Shubhjaiswal408/kbc-fastest-finger-first/(commit log)

2026-11-03 KBC Buzzer: Fastest Finger First quiz system for ESP32
    - Host firmware: game logic, ESP-NOW radio, non-blocking web server,
    embedded web app (gzip), optional school Wi-Fi via wifi_secrets.h
    - USB buzzer firmware (ESP32): self-pairing, fair reaction timing,
    live button test, logs over the radio
    - Battery buzzer firmware (XIAO ESP32-C6, beta): deep sleep between
    presses, self-calibrated wake delay
    - Web app: teacher console, KBC-style big screen, 2-4 option questions,
    scoreboard, history, button test, logs, settings; demo mode
    - Docs: README, user guide, hardware guide, screenshots, wiring diagrams
    [KBC_BatteryC6.ino, KBC_Host.ino, KBC_Node.ino, mini_web.h, protocol.h, wifi_secrets.example.h]
2026-11-04 Add ESP32-C3 SuperMini battery buzzer firmware (beta) and docs
    [KBC_BatteryC3.ino, protocol.h]
2026-11-04 C3 battery buzzer: fix Wi-Fi (lower TX power), add wiring check and diagnostics; show battery buzzers as asleep
    - C3 SuperMini: TX power 8.5 dBm (fixes boards with a poorly tuned antenna)
    - 15 s wiring check after power-on, reset reason and pin levels in the boot log
    - Report wake-ups with no pin flagged instead of sleeping silently
    - Web app: battery buzzers show an amber 'asleep' state and a separate count
    [KBC_BatteryC3.ino]
2026-11-05 Make the ESP32-C3 SuperMini the main buzzer; explanation-style docs with diagrams
    - README rewritten around the C3 SuperMini battery buzzer
    - New docs/HOW_IT_WORKS.md: radio, pairing, fair timing, sleep, channels, web server, limits
    - Hardware guide: C3 pinout, wiring, power options, PCB netlist and layout rules
    - New diagrams: C3 pinout, C3 wiring, PCB layout guide, battery timing; updated system overview
    - Fresh screenshots; web app wiring card and demo now show C3 buzzers
2026-11-05 Add web flasher (ESP Web Tools on GitHub Pages)
    - docs/flasher: install page with cards for the C3 battery buzzer, host,
    USB buzzer and XIAO C6, ready-built firmware and manifests
    - Public host firmware is built without wifi_secrets.h
    - README and hardware guide link to the flasher
2026-11-06 Host v1.3.0: use both cores, non-blocking keep-alive web server, fixes
    - web server in its own task on core 0, game/radio alone on core 1 (woken per packet)
    - MiniWeb: keep-alive, non-blocking queued replies, 413 for oversized bodies
    - player saves deferred out of the game task (flash writes stall both cores)
    - Serial TX buffer so logging never blocks the game
    - 0.3 s reveal grace; late USB presses made before the lock now count
    - fix STATE elapsed after lock, cap round time, logs after host restart, factory reset
    [KBC_Host.ino, mini_web.h]
2026-11-06 Host v1.3.1 + swarm test: 30 virtual buzzers on 2 ESP32s
    - tools/KBC_Swarm: one ESP32 plays up to 20 buzzers (battery or USB) over real ESP-NOW
    - tools/swarm_test.py: runs normal, burst, time-limit edge, false-start, absent and
    teacher-lock rounds and checks every press, its timing and the winner
    - host test mode (/api/test, RAM only, off at boot)
    - fix: state JSON could lose text under memory pressure; now sized up front,
    cached for 40 ms and shared between browsers from 3 reused buffers
    - MiniWeb never sends half a reply; the page skips 'busy' replies
    [KBC_Host.ino, KBC_Swarm.ino, mini_web.h, protocol.h, swarm_test.py]
2026-11-06 Host v1.3.1: web server hardening found by the 30-buzzer swarm test
    - 12 connection slots; when full, close an idle kept-alive one, never one mid-request
    - state JSON buffers sized for 40 buzzers up front; on a failed rebuild serve the
    last good copy instead of 'busy'
    - logs sent in pages of 40 lines (no 30 KB block needed)
    - state JSON reports the largest free memory block and build failures
    - swarm test: browser-style connections, retries, survives a failed round, --only
    [KBC_Host.ino, mini_web.h, swarm_test.py]
